benson20010606/STM32-BOOST-CONVERTER/pic/circuit_real.jpg

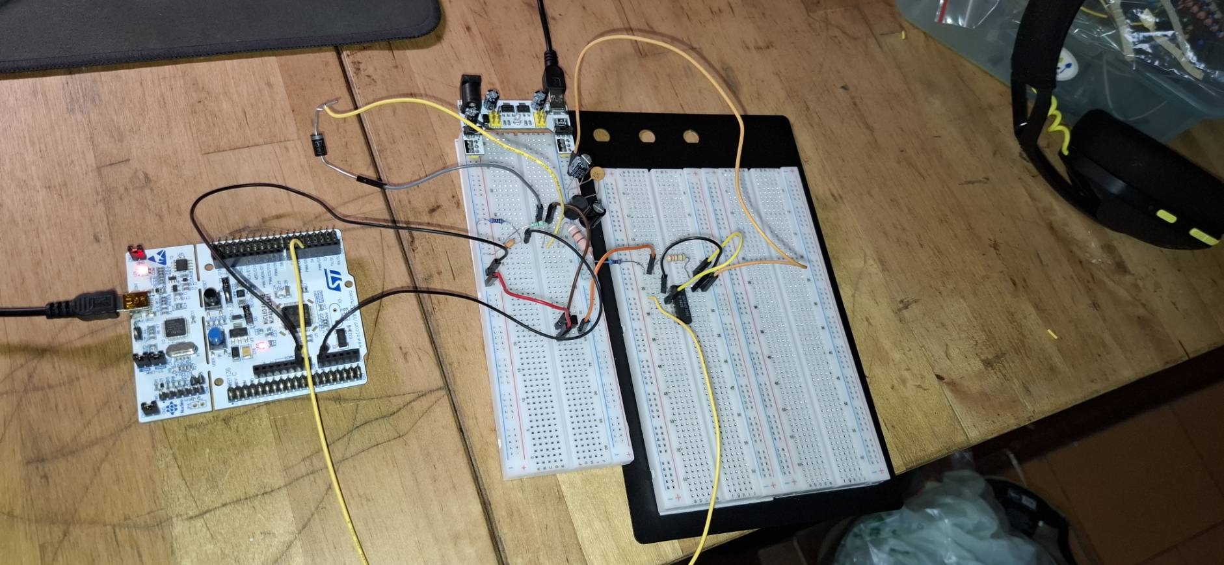
pic/circuit_real.jpg
