benson20010606/STM32-BOOST-CONVERTER/(commit log)

2026-08-14 feat: add timer-driven ADC sampling and interrupt UART telemetry
    - add TIM2 5 kHz TRGO for ADC sampling
    - add ADC interrupt handling and measurement update
    - add TIM4 50 Hz telemetry scheduling
    - add interrupt-driven USART2 TX
    - add PWM duty abstraction with 30% nominal startup duty
    - verify ADC input using fixed divider and potentiometer
    [BootsConverter.ioc, main.c]
2026-08-14 feat: add output voltage feedback conversion
    - add voltage divider feedback parameters
    - convert ADC voltage to output voltage
    - include Vout in UART telemetry
    - verify feedback conversion with 3.3 V input
2026-08-14 feat: complete boost controller firmware baseline
    - add 5 kHz timer-triggered ADC feedback loop
    - add PI voltage controller with 30% feed-forward duty
    - add duty saturation and integral anti-windup
    - limit integral contribution to prevent excessive windup
    - add latched over-voltage protection
    - add low-feedback timeout protection
    - add 50 Hz interrupt-driven UART telemetry
    - configure 47k/10k output-voltage feedback divider
    - document control and protection firmware
    [main.c]
2026-08-15 feat: validate boost hardware and add real-time telemetry plot
    - verify 5 V to 7 V boost conversion on hardware
    - validate closed-loop PI voltage regulation
    - compare fixed-duty, P, and PI transient responses
    - update nominal feed-forward duty to 28.6%
    - add 100-sample Vout averaging for telemetry
    - change UART telemetry to CSV format
    - add real-time Vout and PWM duty visualization
    - add plot reset and fixed display ranges
    - verify UART feedback and duty response during hardware tests
    [main.c, plot.py]
